thanhnguyen0801/DESIGN-CONTROLLER-FOR-DC-MOTOR/PCB/PCB 3D.png

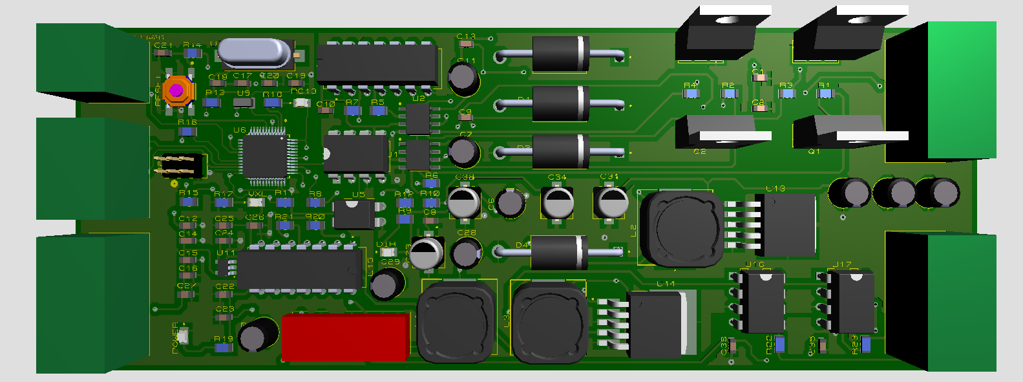
PCB/PCB 3D.png
