thanhnguyen0801/DESIGN-CONTROLLER-FOR-DC-MOTOR/PCB/PCB REAL.png

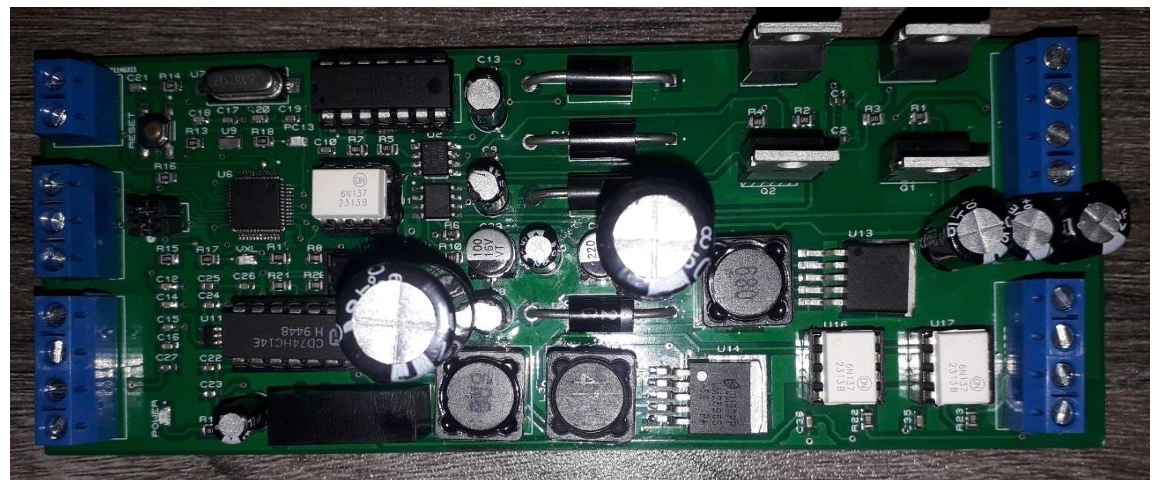
PCB/PCB REAL.png
