thanhnguyen0801/DESIGN-CONTROLLER-FOR-DC-MOTOR/README.md

# DESIGN-CONTROLLER-FOR-DC-MOTOR
# STEP 1
Design pcb for dc motor max electric power 100(w), read encoder, protocol uart, max voltage input 40vdc. 
# STEP 2
Design velocity controller (PI)
# STEP 3
DESIGN guide to control 

# Video demo 
https://youtu.be/Mid02ilqlOs
