thanhnguyen0801/DESIGN-CONTROLLER-FOR-DC-MOTOR/(list of files, drawings)

Other design files:
PCB/h_bridge_controller_dc_servo.pdsprj
